ambitiouskain/everything-evenhub/hardware/r1-ring-sizer/stl/R1_sizer_17.1.stl

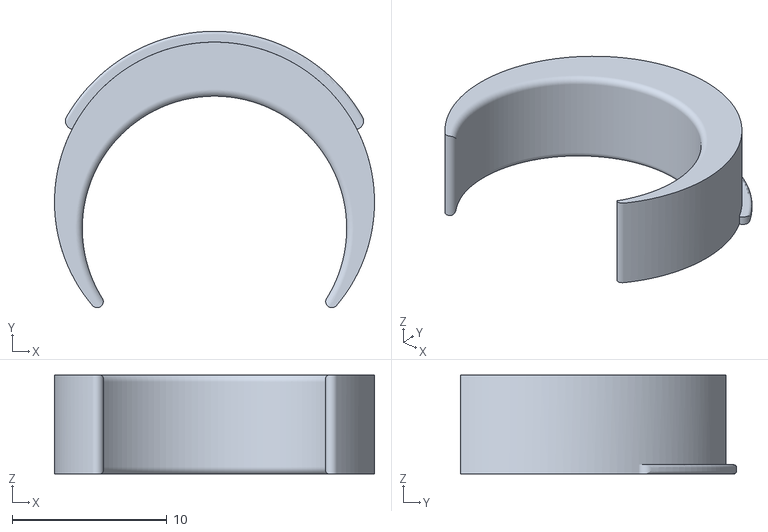
[picture p3: CAD file, 2026-10-14]
hardware/r1-ring-sizer/stl/R1_sizer_17.1.stl
20.7 x 17.9 x 6.40
