ambitiouskain/everything-evenhub/hardware/r1-ring-sizer/stl/R1_sizer_16.5.stl

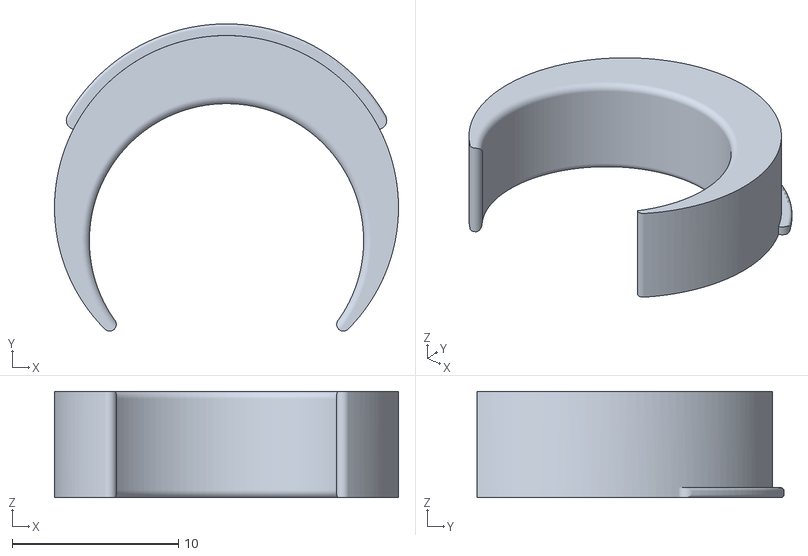
[picture p4: CAD file, 2026-10-14]
hardware/r1-ring-sizer/stl/R1_sizer_16.5.stl
20.7 x 18.5 x 6.40
