ambitiouskain/everything-evenhub/hardware/r1-ring-sizer/stl/R1_sizer_16.8.stl

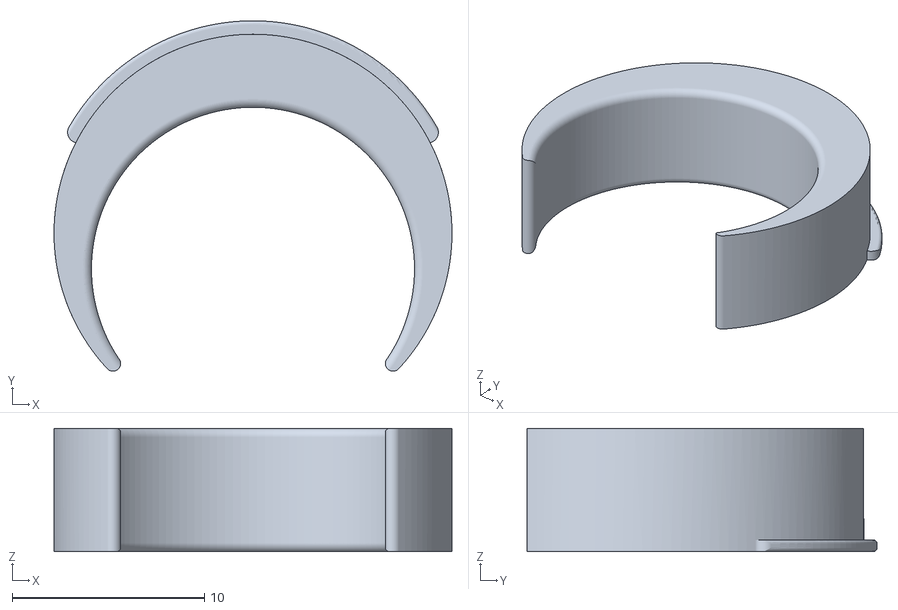
[picture p5: CAD file, 2026-10-14]
hardware/r1-ring-sizer/stl/R1_sizer_16.8.stl
20.7 x 18.2 x 6.40
