ambitiouskain/everything-evenhub/(commit log)

2026-10-13 hardware: parametric Fusion script for an Even R1 ring sizer insert
    Eccentric C-shaped TPU insert for a 20.5 mm R1 on an 18.5 mm finger:
    thick at the back of the finger, open over the sensor so the finger is
    pressed onto it, with optional lips over the ring faces. The Fusion
    script opens a parameter dialog (ring/finger sizes, fit, sensor window,
    lips, size variants, STL export) and rounds edges with revolve cuts
    instead of fillets. Includes a CadQuery replica used to validate the
    geometry, ready-to-print STLs for three sizes, and previews.
    Claude-Session: https://claude.ai/code/session_01KKH7kzkbXws7SpzF1Sxgr8
    [R1_sizer_18.5.stl, R1_sizer_18.7.stl, R1_sizer_18.9.stl]
2026-10-14 hardware: tighten R1 sizer defaults after fit test
    An 18.9 mm hole printed at least 1 mm too loose. Default finger
    diameter is now 17.7 mm (17.9 mm hole, 2.7 mm at the top), the bundled
    STLs are a 17.3/17.6/17.9 test set, and the README gains a fit-tuning
    table and refreshed previews.
    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
    [R1_sizer_17.3.stl, R1_sizer_17.6.stl, R1_sizer_17.9.stl, R1_sizer_18.5.stl, R1_sizer_18.7.stl, R1_sizer_18.9.stl]
2026-10-14 hardware: size R1 sizer from the stacked-insert fit test
    Two single-lip inserts (18.5 + 18.9) clipped together fit snugly; their
    stack models as a 16.4 mm effective hole with 3.8 mm at the top. Default
    is now a 16.8 mm hole (finger 16.6) with a one-side lip, which keeps the
    stack's top thickness and slightly thinner sides. Adds tools/stack_fit.py
    to compute the effective hole of two clipped inserts, and replaces the
    bundled STLs with a 16.5/16.8/17.1 single-lip set.
    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
    [R1_sizer_16.5.stl, R1_sizer_16.8.stl, R1_sizer_17.1.stl, R1_sizer_17.3.stl, R1_sizer_17.6.stl, R1_sizer_17.9.stl]
